justwool/emaskcovid19/E-Mask Adapter_Final Version 31032020.STL

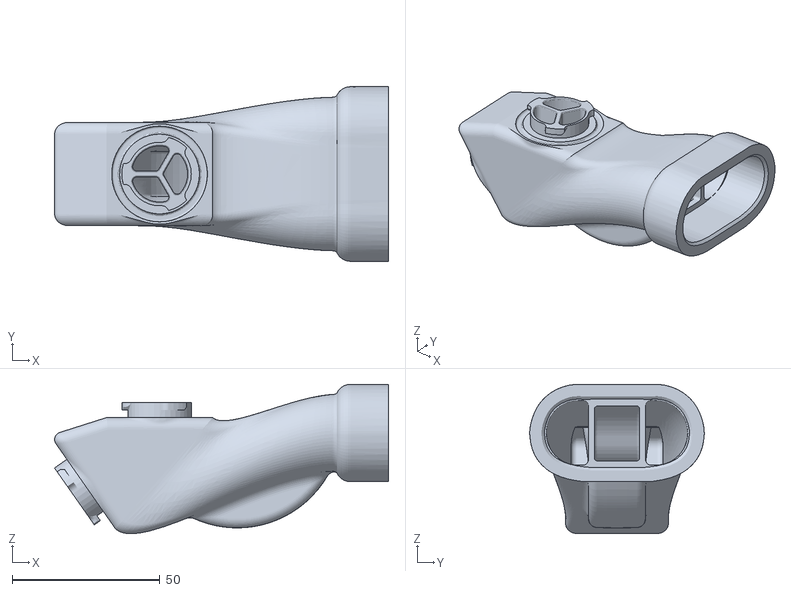
[picture p12: CAD file, 2020-04-03]
E-Mask Adapter_Final Version 31032020.STL
113.1 x 59.1 x 50.5
