justwool/emaskcovid19/(commit log)

2020-04-03 Add files via upload
    Erebus motosport emask to 3m filter connector.
    [E-Mask Adapter_Final Version 31032020.STL]
2020-04-03 Add files via upload
    Ventilator valves for emaks 3 types of masks
2020-04-03 Add files via upload
    "I have designed and created what we feel is functional PAPR made out of a full face swim mask, tubing, computer fan, HEPA filter and 3D printed parts all powered by a 5V USB powerbank."
